DEVARSH-97/Dual_Active_Bridge_Converter/README.md

# Dual_Active_Bridge_Converter
Implementation of Dual Active Brdige converter
