DEVARSH-97/Dual_Active_Bridge_Converter/Draft16.asc

C1: cap; 0.01µ
C2: cap; 10n
C3: cap; 0.01µ
C4: cap; 0.01µ
C5: cap; 0.01µ
C6: cap; 0.01µ
C7: cap; 0.01µ
C8: cap; 1m
C9: cap; 0.01µ
D1: diode; 1N4148
D2: diode; 1N4148
D3: diode; 1N4148
D4: diode; 1N4148
D5: diode; 1N4148
D6: diode; 1N4148
D7: diode; 1N4148
D8: diode; 1N4148
L1: ind2; 20m
L2: ind2; 20m
L3: ind2; 500µ
M1: nmos; BSC028N06LS3
M2: nmos; BSC028N06LS3
M3: nmos; BSC028N06LS3
M4: nmos; BSC028N06LS3
M5: nmos; BSC027N04LS
M6: nmos; BSC027N04LS
M7: nmos; BSC027N04LS
M8: nmos; BSC027N04LS
R1: res; 10
R2: res; 10
R3: res; 10
R4: res; 10
R5: res; 10
R6: res; 10
R7: res; 10
R8: res; 10
R9: res; 100
R10: res; 10
R11: res; 10
R12: res; 10
R13: res; 10
R14: res; 10
R15: res; 10
R16: res; 10
R17: res; 10
V1: voltage; PULSE(0 5 0 1n 1n 9.75u 20u)
V2: voltage; PULSE(0 5 10u 1n 1n 9.75u 20u)
V3: voltage; PULSE(0 5 10u 1n 1n 9.75u 20u)
V4: voltage; PULSE(0 5 0 1n 1n 9.75u 20u)
V5: voltage; 30
V6: voltage; PULSE(0 5 4u 1n 1n 9.75u 20u)
V7: voltage; PULSE(0 5 14u 1n 1n 9.75u 20u)
V8: voltage; PULSE(0 5 14u 1n 1n 9.75u 20u)
V9: voltage; PULSE(0 5 4u 1n 1n 9.75u 20u)
V10: voltage; 24
Named nets: 0
.tran 300m
K L1 L2 1
